kvantoriumnel/rzd_project/hoverboard-firmware-hack-FOC-main/docs/pictures/mainboard_pinout.png

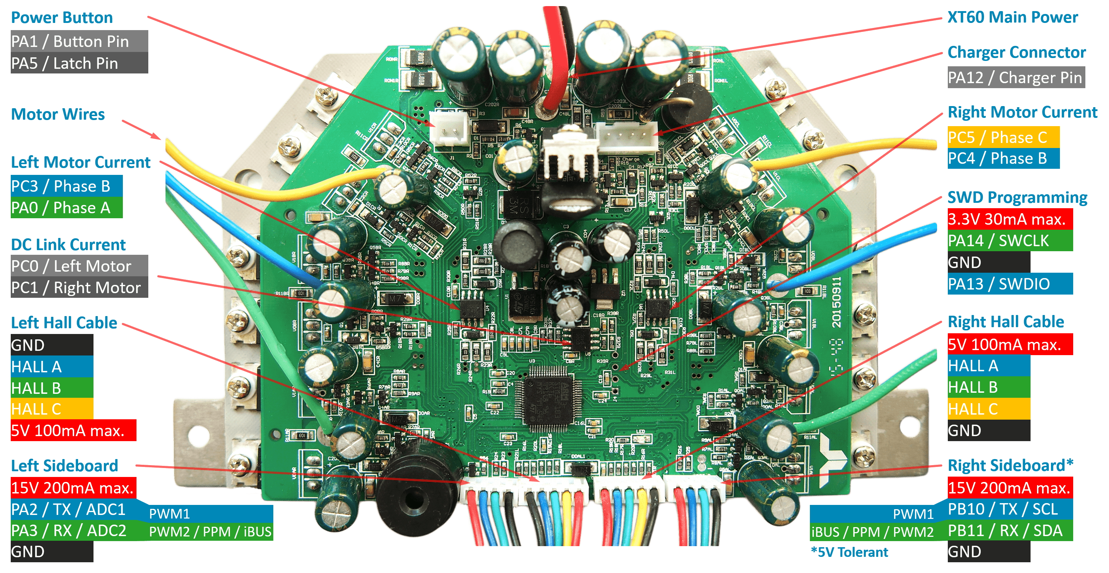
hoverboard-firmware-hack-FOC-main/docs/pictures/mainboard_pinout.png
