kvantoriumnel/rzd_project/README.md

# АРГУС-01

> **Переносной роботизированный комплекс для автономного мониторинга и диагностики на объектах железнодорожной инфраструктуры**

---

## О проекте

**«Аргус-01»** — это переносной роботизированный комплекс, разработанный командой **детского технопарка «Кванториум» НЭЛ (г. Пенза)**. 

Комплекс представляет собой две рельсовые тележки на мотор-колёсах со съёмными поперечинами. Над каждым рельсом установлен свой комплект датчиков, а сама колея задаёт маршрут движения. 

Проект **не заменяет** тяжелые вагоны-путеизмерители и дефектоскопы, а **закрывает промежутки между их проходами**, которые в настоящее время закрываются пешим обходом бригад.

*   **Проблема:** Между проходами диагностических средств путь осматривает пешком бригада из 2 человек (до 10 км за смену) на действующем пути.
*   **Решение:** Автономная тележка, которая проходит этот маршрут быстрее, безопаснее и собирает больше данных.

---

##  Ключевые особенности и функции

*   **Автономность:** План — 90% операций без оператора (сейчас — не менее 70%). Управление можно перехватить с пульта.
*   **Обнаружение дефектов:** По запросу заказчика — до **18 классов** по № 2499р и № 2288р (код и степень опасности). На конкурсе заявлено 3 класса.
*   **Универсальность колеи:** Подходит для магистральных путей (1520 мм), европейской колеи (1435 мм), узкоколейных и детских железных дорог (750 мм), промышленных и карьерных (600–1067 мм). Колея задаётся длиной поперечины и параметром ПО. Пороги — под тип рельса (P24–P75).
*   **Мобильность:** Масса ≈ 40 кг. Установка занимает 15 минут. Комплекс разборный и перевозится в защитном корпусе.
*   **Нештатные ситуации:** 
    *   Препятствие — стоп за 0,5 м.
    *   Потеря связи — стоп через 0,5 с.
    *   Удар на стыке фиксирует IMU.

---

##  Технические характеристики

| Параметр | Значение |
| :--- | :--- |
| **Тип** | Рельсовый, 2 тележки, мотор-колёса Ø254 мм |
| **Скорость** | 0,3–0,5 м/с |
| **Колея** | 750 / 1520 мм (смена поперечин) |
| **Датчики** | 2 камеры, 4 лазерных дальномера, 2 IMU, 2 ультразвуковых датчика |
| **Вычислительное** | Ноутбук с GPU, ESP32; Wi-Fi, пульт управления |
| **Работа / Ход** | Прототип: до 15 мин / до 0,45 км. **Серийный: до 5 ч / до 9 км** |
| **Связь** | С пульта — до 3 км (прямая видимость) |
| **Измерение** | Ступенька и зазор — лазерным дальномером; колея — двумя дальномерами на рабочие грани |

---

## Путь оператора

1.  **Монтаж (15 мин):** Перемещение оборудования в защитном корпусе по маршруту и установка на пути.
2.  **Инициализация:** Формирование задания на устройстве оператора (дистанция, выбор датчиков).
3.  **Проверка:** Калибровка колеи по шаблону, статус «норма».
4.  **Диагностика:** Комплекс работает автономно. На экране отображаются дефекты. Пульт имеет функции аварийной остановки и дистанционного перехвата.
5.  **Отчёт:** Таблица дефектов, снимки с рамками и классами, журнал CSV и сводка по проходу — сразу после прохода.
6.  **Демонтаж:** Снятие комплекса и укладка в защитный корпус.

---

## Экономическая и социальная целесообразность

### Сравнение с аналогами

| Аналог | Плюсы | Минусы |
| :--- | :--- | :--- |
| **Вагон-лаборатория «Интеграл»** | ≈ 200 параметров, до 140 км/ч | Дорого, проходы по графику, редко |
| **Тележка ПТ-7МК** | Колея ± 1 мм | ≈ 2,3 млн ₽, ведёт человек |
| **RailPod (США)** | Автономна, камеры и лидар | Колея 1435, в РФ недоступна |

### Финансовые показатели

*   **Стоимость прототипа:** 336 614 ₽ (материалы, специалисты, оборудование, интеграция).
*   **Серийный комплект:** 1,02 млн ₽ (при партии 100 шт.), что составляет **44% цены ПТ-7МК**.
*   **Стоимость 1 км осмотра:** **537 ₽** (против 862 ₽ пешком, экономия ~38%).
*   **Социальный эффект:** Экономия **7 680 чел.-ч в год** (снижение работы людей на действующем пути).
*   **Выигрыш покупателя (дистанция пути):** 
    *   Общий парк на 2 соседние дистанции по 100 км.
    *   4 осмотра в месяц, парку передано 50% пеших осмотров.
    *   Необходимо: 3 комплекса + 1 оператор.
    *   Вложения: 4,07 млн ₽.
    *   **Экономия: 2,38 млн ₽ в год.**
    *   **Окупаемость: 21 месяц.**
    *   NPV за 5 лет: 4,09 млн ₽ (ставка 14%).
    *   *При 30% осмотров окупаемость — 38 мес, при 70% — 20 мес.*

---

##  Команда проекта

*   **Кардашов Дмитрий Сергеевич** — схемотехник-электронщик
*   **Андриянов Владислав Евгеньевич** — программист (компьютерное зрение)
*   **Штыров Артур Сергеевич** — инженер-конструктор

**Организация:** Детский технопарк «Кванториум» НЭЛ, г. Пенза.
