kvantoriumnel/rzd_project/hoverboard-firmware-hack-FOC-main/docs/pictures/mainboard_pics.pptx

PA1 / Button Pin

PA5 / Latch Pin

Power Button

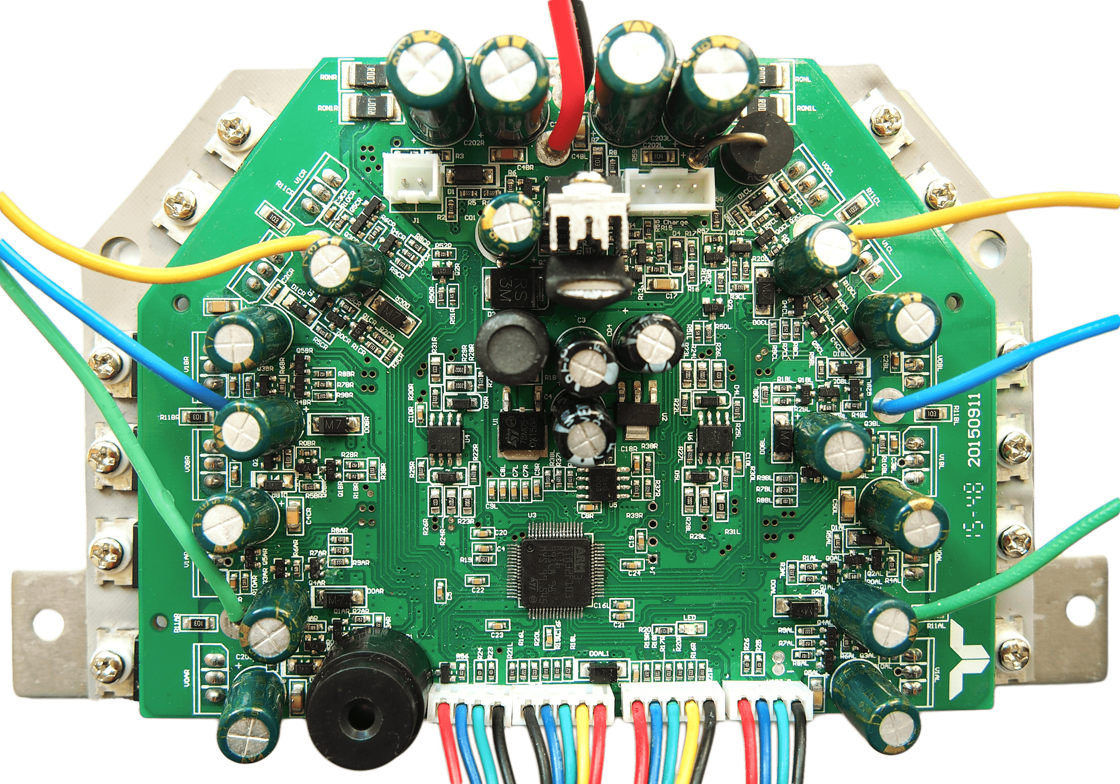
[picture p3: figure]

XT60 Main Power

Charger Connector

PA12 / Charger Pin

Motor Wires

PC5 / Phase C

Right Motor Current

PC4 / Phase B

PC3 / Phase B

Left Motor Current

PA0 / Phase A

SWD Programming

3.3V 30mA max.

DC Link Current

PC0 / Left Motor

PC1 / Right Motor

PA13 / SWDIO

GND

PA14 / SWCLK

Left Hall Cable

GND

HALL A

Right Hall Cable

5V 100mA max.

HALL A

5V 100mA max.

HALL C

HALL B

HALL C

GND

HALL B

Left Sideboard

15V 200mA max.

PA2 / TX / ADC1

PA3 / RX / ADC2

PWM1

PWM2 / PPM / iBUS

PWM1

iBUS / PPM / PWM2

Right Sideboard*

15V 200mA max.

PB10 / TX / SCL

PB11 / RX / SDA

GND

*5V Tolerant

GND

## Slide 2

VARIANT_HOVERCAR

Power Button

RC circuit (optional)

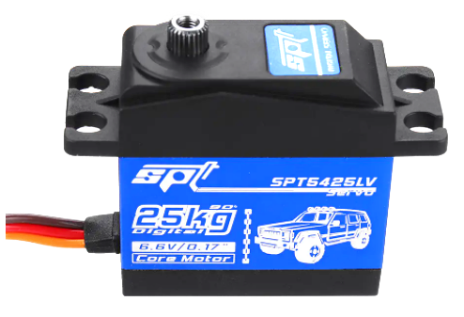
[picture p4: figure]

Steering Servo
min. 25kg

XT60 Main Power

VDD 36V - 42V

FOC
Sinusoidal
Commutation

Pedals
RC

Voltage
Speed
Torque

Pull-down
resistors

Left Cable

GND

Switch

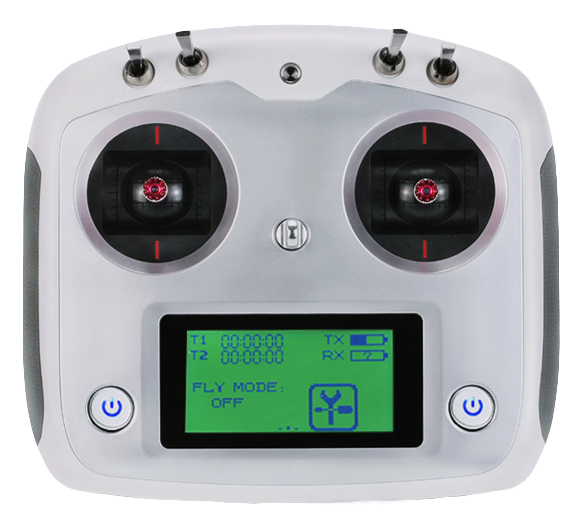
[picture p5: figure]

Input

Control Type

Flysky i6S

Control Mode

Field W.

Off
On

PA2 / TX / ADC1

100k

100k

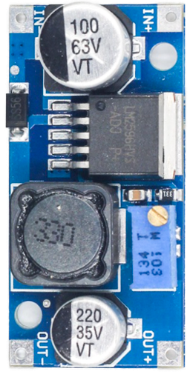
[picture p6: figure]

In: 36V - 42V

DC-DC Converter
LM2596HV

Out: 6.6V

CH4 / Servo

CH7

SWA

CH8

SWB

CH9

SWC

CH10

SWD

CH1 / Steer

CH2 / Speed

CH2 Failsafe: 0%

PA3 / RX / ADC2

GND

3.3V 30mA max.

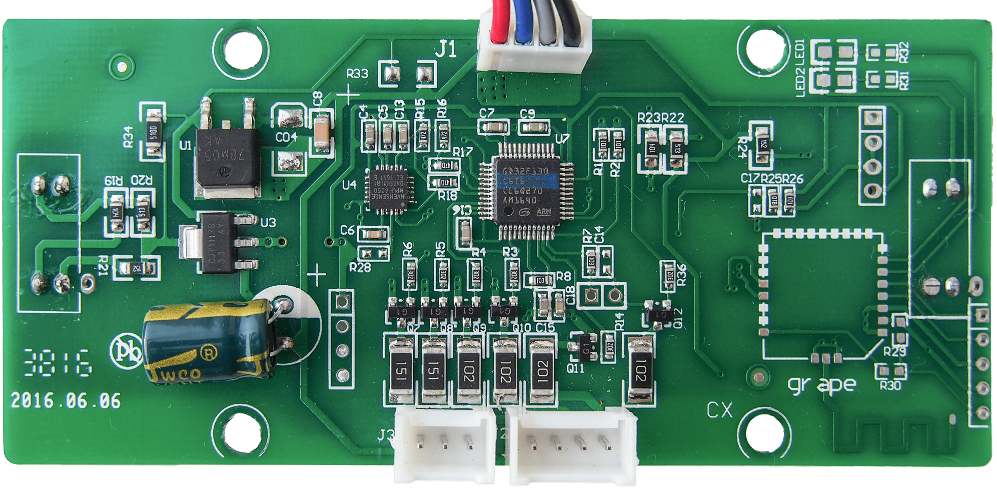
[picture p7: figure]
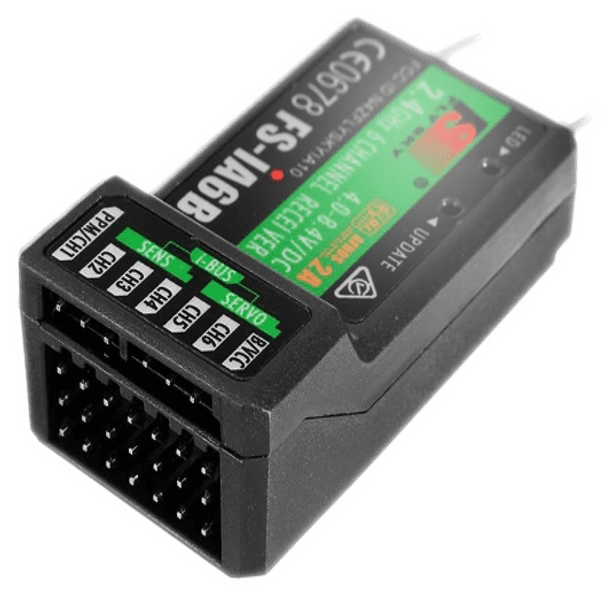
[picture p8: figure]

Right Cable

Brake

Throttle

CH4

parallel connection

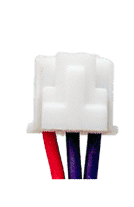
[picture p9: figure]
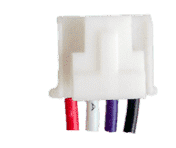
[picture p10: figure]

100 Ohm

FS-iA6B iBUS

GND

PA10 / AUX_RX

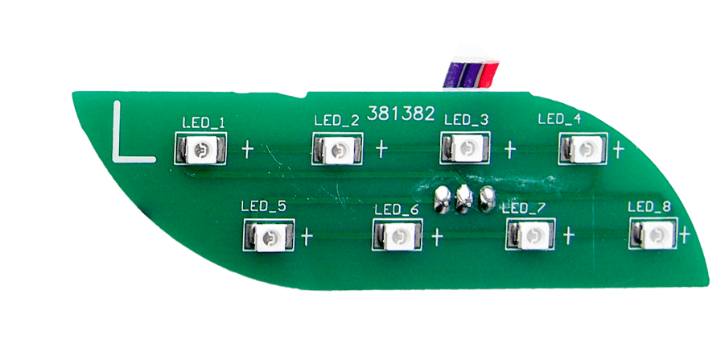
[picture p11: figure]
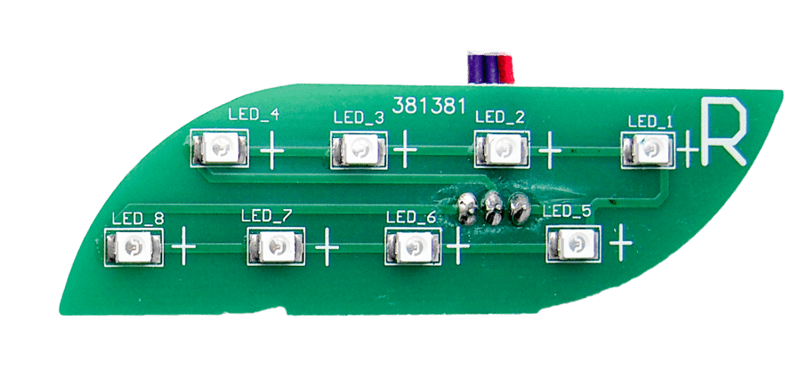
[picture p12: figure]

Front LEDs

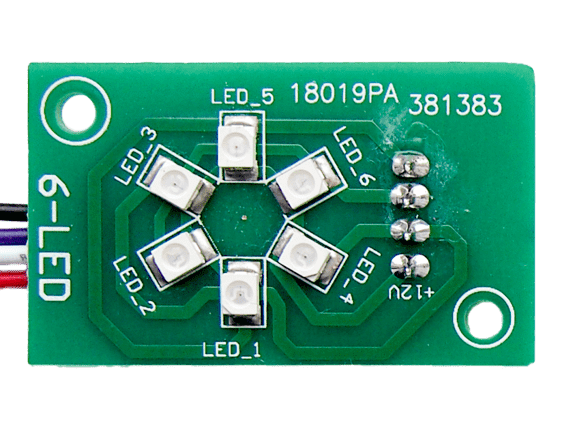
[picture p13: figure]

Battery Level
