kvantoriumnel/rzd_project/hoverboard-firmware-hack-FOC-main/docs/pictures/phase_currents_ADC.pptx

IDEAL AREA FOR CURRENT SAMPLING

M2

M2

M2

OBSERVED SPIKES at 90% Duty Cycle
M1 | M2
Yes (Light) | Yes (Hard)
Yes (Hard) | No
Yes (Light) | No
? todo | ? todo

Low FETs ON

Phase Currents
(assumed)

AdcClockSelection = RCC_ADCPCLK2_DIV8;
M1, M2 = 7.5; DC_Link = 13.5;

Default

M1

DC
Link

AdcClockSelection = RCC_ADCPCLK2_DIV8;
M1, M2 = 1.5; DC_Link = 13.5;

M1

DC
Link

AdcClockSelection = RCC_ADCPCLK2_DIV4;
DC_Link = 1.5; M1, M2 = 1.5;

AdcClockSelection = RCC_ADCPCLK2_DIV2;
DC_Link = 7.5; M1, M2 = 1.5;

DC
Link

DC
Link

M1

M1

M2

Still To Try

## Slide 2

TIM8

ADC_M1

Interrupt Mot 1

ADC_M2

Interrupt Mot 2

TIM1

DC
Link

M1

M2

## Slide 3

TIM8 - LEFT

ADC 1

DC Link
RIGHT

M_LEFT
Pha_A

M_RIGHT
Pha_B

Rest

FOC Mot 1 / FOC Mot 2

TIM1 - RIGHT

ADC 2

DC Link
LEFT

M_LEFT
Pha_B

M_RIGHT
Pha_C

Rest
