kvantoriumnel/rzd_project/hoverboard-firmware-hack-FOC-main/docs/pictures/FieldWeakening.png

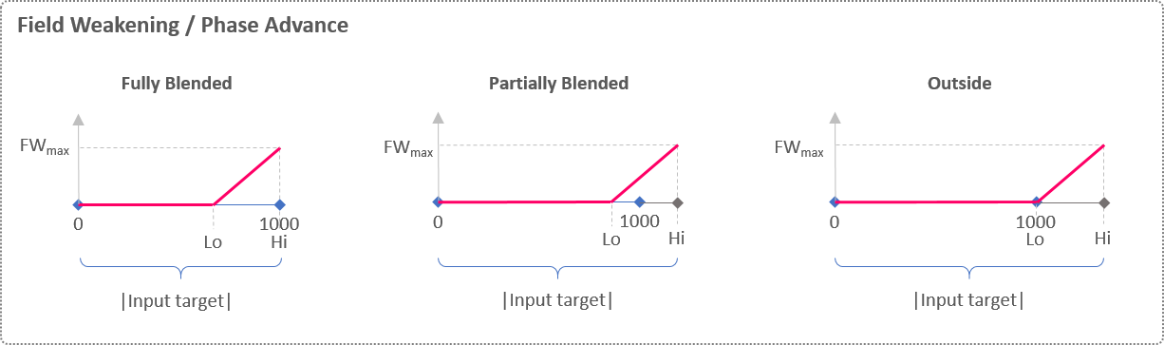
hoverboard-firmware-hack-FOC-main/docs/pictures/FieldWeakening.png
