kvantoriumnel/rzd_project/hoverboard-firmware-hack-FOC-main/docs/pictures/hoverboard_wheel.JPG

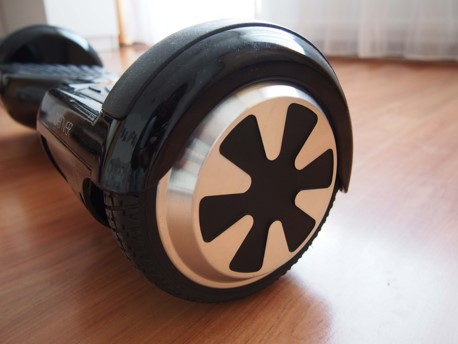
hoverboard-firmware-hack-FOC-main/docs/pictures/hoverboard_wheel.JPG
