kvantoriumnel/rzd_project/hoverboard-firmware-hack-FOC-main/docs/pictures/motor_ferite1.JPG

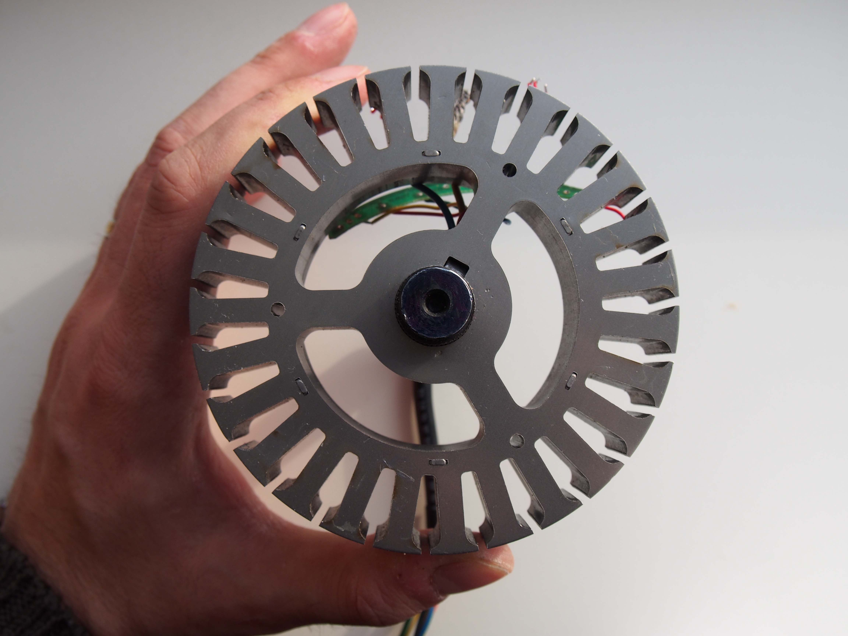
hoverboard-firmware-hack-FOC-main/docs/pictures/motor_ferite1.JPG
