kvantoriumnel/rzd_project/hoverboard-firmware-hack-FOC-main/docs/pictures/motor_ferite2.png

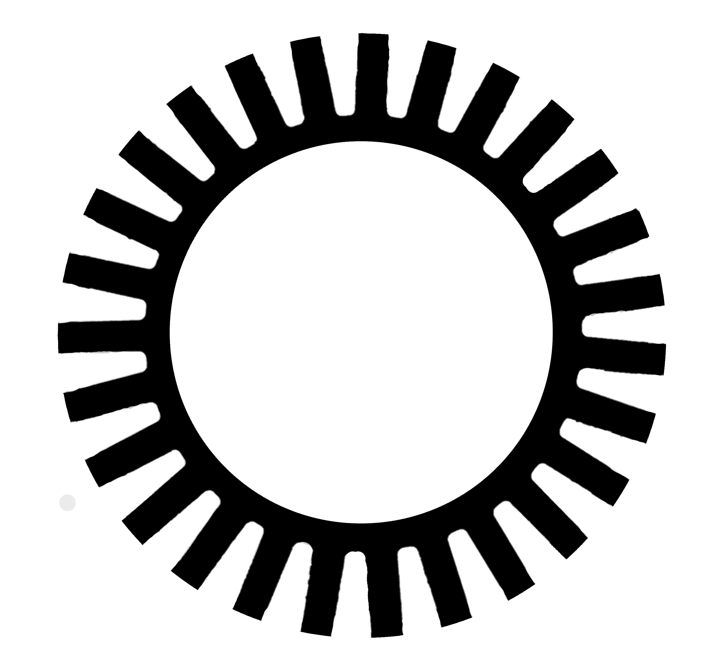
hoverboard-firmware-hack-FOC-main/docs/pictures/motor_ferite2.png
