kvantoriumnel/rzd_project/hoverboard-firmware-hack-FOC-main/docs/pictures/motor_inside.jpg

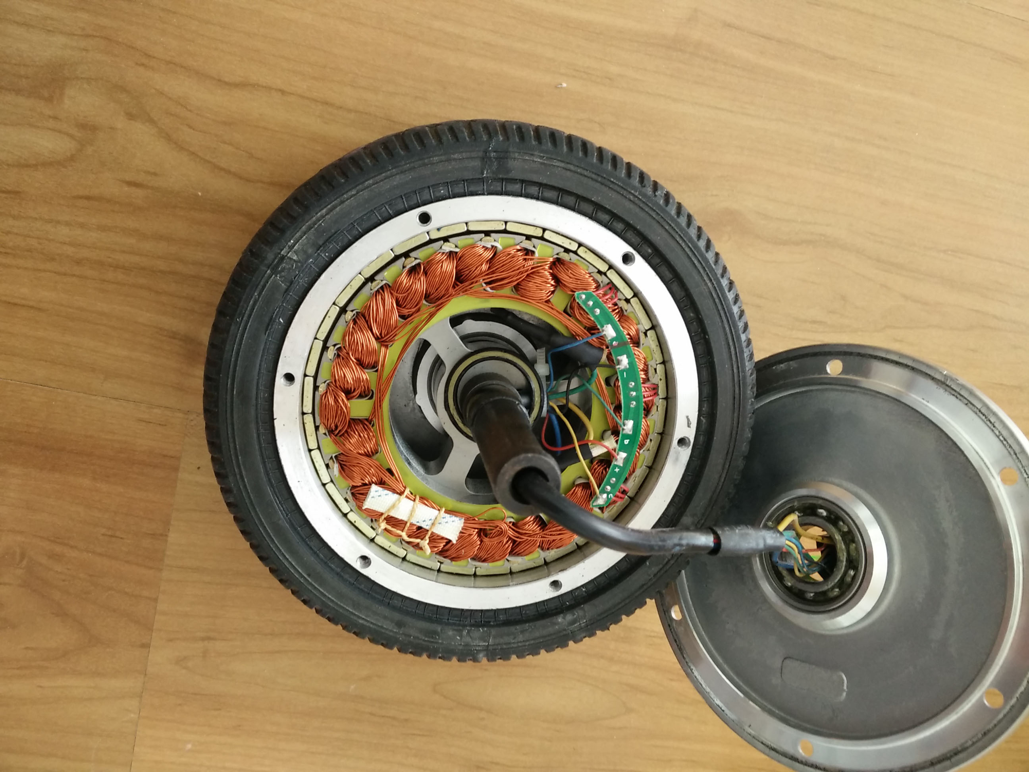
hoverboard-firmware-hack-FOC-main/docs/pictures/motor_inside.jpg
