kvantoriumnel/rzd_project/hoverboard-firmware-hack-FOC-main/docs/pictures/motor_VESC_params.png

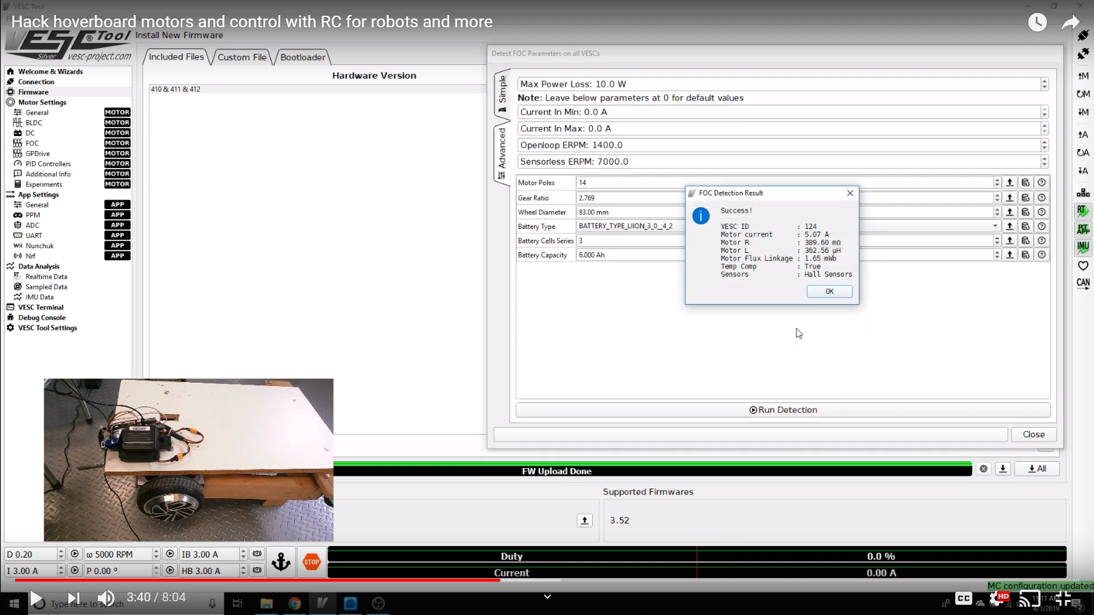
hoverboard-firmware-hack-FOC-main/docs/pictures/motor_VESC_params.png
