kvantoriumnel/rzd_project/hoverboard-firmware-hack-FOC-main/docs/pictures/motor_winding.png

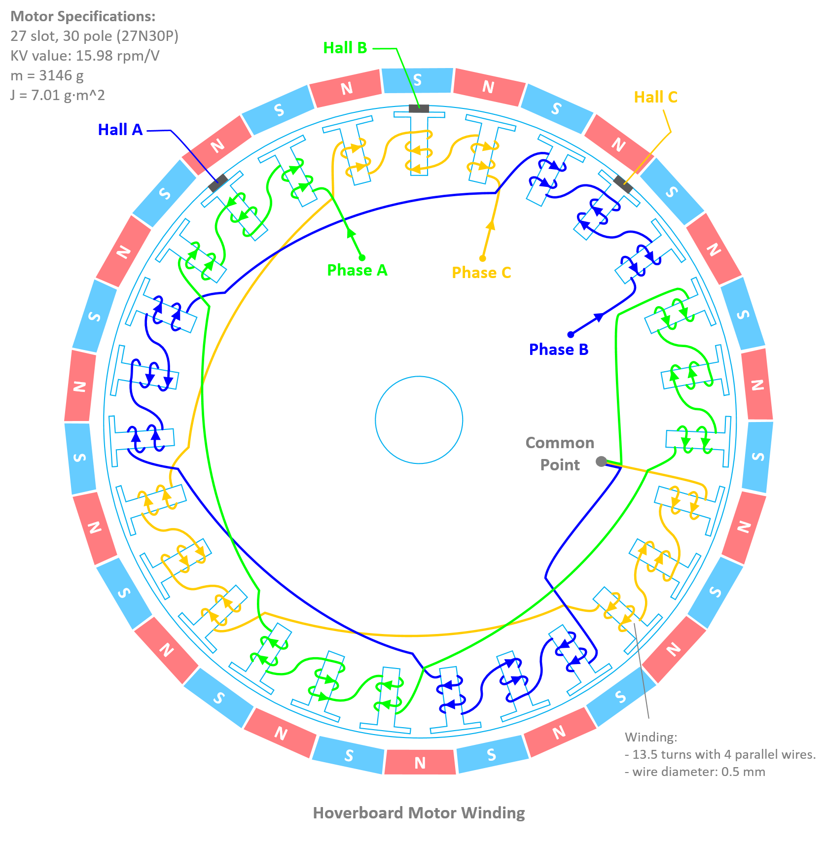
hoverboard-firmware-hack-FOC-main/docs/pictures/motor_winding.png
