kvantoriumnel/rzd_project/hoverboard-firmware-hack-FOC-main/docs/pictures/videos_preview/com_foc_const.png

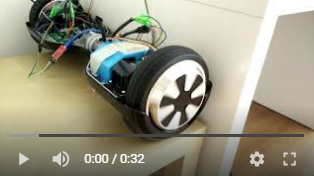
hoverboard-firmware-hack-FOC-main/docs/pictures/videos_preview/com_foc_const.png
