kvantoriumnel/rzd_project/hoverboard-firmware-hack-FOC-main/docs/pictures/videos_preview/com_foc_var.png

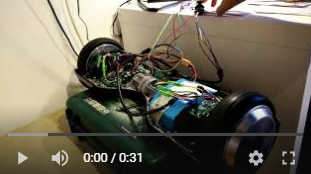
hoverboard-firmware-hack-FOC-main/docs/pictures/videos_preview/com_foc_var.png
