kvantoriumnel/rzd_project/hoverboard-firmware-hack-FOC-main/docs/pictures/videos_preview/cruise_control.png

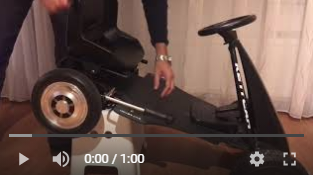
hoverboard-firmware-hack-FOC-main/docs/pictures/videos_preview/cruise_control.png
