kvantoriumnel/rzd_project/hoverboard-firmware-hack-FOC-main/docs/pictures/videos_preview/hovercar_intro.png

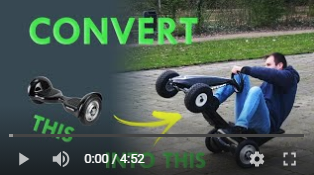
hoverboard-firmware-hack-FOC-main/docs/pictures/videos_preview/hovercar_intro.png
