kvantoriumnel/rzd_project/hoverboard-firmware-hack-FOC-main/docs/pictures/videos_preview/hovercar_pedals.png

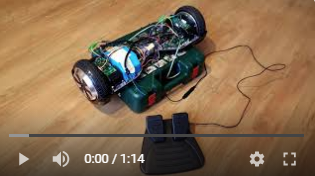
hoverboard-firmware-hack-FOC-main/docs/pictures/videos_preview/hovercar_pedals.png
