kvantoriumnel/rzd_project/hoverboard-firmware-hack-FOC-main/docs/pictures/videos_preview/serial_com.png

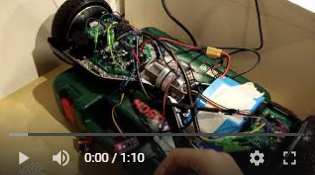
hoverboard-firmware-hack-FOC-main/docs/pictures/videos_preview/serial_com.png
