kvantoriumnel/rzd_project/hoverboard-firmware-hack-FOC-main/docs/pictures/wiki_hovercar/hovercar_rc.png

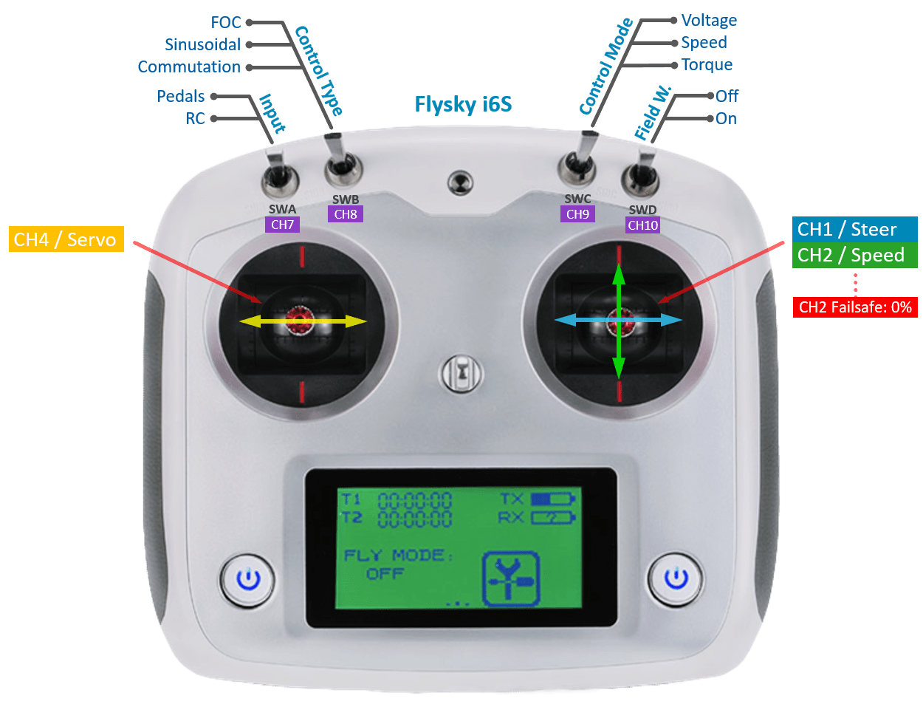
hoverboard-firmware-hack-FOC-main/docs/pictures/wiki_hovercar/hovercar_rc.png
