kvantoriumnel/rzd_project/hoverboard-firmware-hack-FOC-main/docs/pictures/wiki_unlock/unlock_mcu_3.png

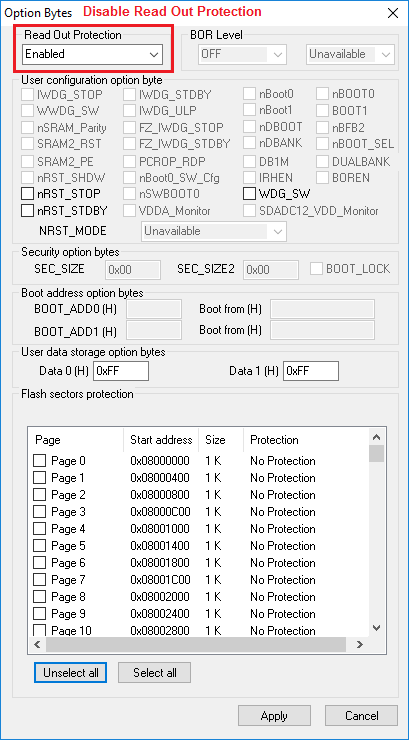
hoverboard-firmware-hack-FOC-main/docs/pictures/wiki_unlock/unlock_mcu_3.png
