kvantoriumnel/rzd_project/hoverboard-firmware-hack-FOC-main/docs/literature/ODrive motor guide.xlsx

Sheet: Motors
(feilds highlighted in blue are inputs) | kv | Max current | Max voltage | price | Weight | Link | Torque | No-load speed |  |  | Force | Acceleration | Time to base speed | distance to base speed | Power at base speed | Base speed kinetic energy | Encoder freq. (base speed)
 | rpm/v | A | V | USD | g |  | Nm | rpm | rad/s | m/s | N | m/s^2 | ms | mm | W | J | kHz
Tarot 4008 330kv | 330 | 25 | 24 | 32 | 80 | https://www.aliexpress.com/item/F17601-Tarot-4008-Martin-RC-Brushess-Motor-TL2955-RC-Quadcopter-Motor-for-Quadcopter-Multicopter-Drone/32697306634.html | 0.63 | 7920 | 829.38 | 7.92 | 65.61 | 21.89 | 361.74 | 1432.50 | 519.6152423 | 59.59 | 270.336
Turnigy Aerodrive SK3 - 4250-350kv | 350 | 50 | 20 | 36 | 266 | https://hobbyking.com/en_us/turnigy-aerodrive-sk3-4250-350kv-brushless-outrunner-motor.html | 1.18 | 7000 | 733.04 | 7.00 | 123.72 | 41.29 | 169.55 | 593.42 | 866.0254038 | 46.55 | 238.9333333
ACK 5312CP - 330KV | 330 | 50 | 30 | 41 | 230 | https://hobbyking.com/en_us/ack-5312cp-330kv-high-performance-brushless-multicopter-motor-6-8s-cw.html | 1.25 | 9900 | 1036.73 | 9.90 | 131.22 | 43.79 | 226.09 | 1119.14 | 1299.038106 | 93.11 | 337.92
Turnigy Aerodrive SK3 - 5065-275kv | 275 | 60 | 40 | 56 | 530 | https://hobbyking.com/en_us/turnigy-aerodrive-sk3-5065-275kv-brushless-outrunner-motor.html | 1.80 | 10560 | 1105.84 | 10.56 | 188.95 | 63.05 | 167.47 | 884.26 | 1995.32253 | 105.94 | 360.448
ODrive Robotics D5065 - 270kv | 270 | 65 | 32 | 69 | 420 | https://odriverobotics.com/shop/odrive-custom-motor-d5065 | 1.99 | 8640 | 904.78 | 8.64 | 208.49 | 69.57 | 124.18 | 536.47 | 1801.33284 | 70.92 | 294.912
KEDA 63-64 190KV | 190 | 50 | 40 | 49 | 670 | https://hobbyking.com/en_us/kd-53-30-high-voltage-brushless-outrunner-190kv.html | 2.18 | 7296 | 764.04 | 7.30 | 227.90 | 76.05 | 95.93 | 349.97 | 1662.768775 | 50.57 | 249.0368
ODrive Robotics D6374 - 150kv | 150 | 70 | 48 | 99 | 890 | https://odriverobotics.com/shop/odrive-custom-motor-d6374-150kv | 3.86 | 5760 | 603.19 | 5.76 | 404.15 | 134.87 | 42.71 | 123.00 | 2327.876285 | 31.52 | 196.608
Turnigy Aerodrive SK3 - 6374-149kv | 149 | 68 | 48 | 80 | 840 | https://hobbyking.com/en_us/turnigy-aerodrive-sk3-6374-149kv-brushless-outrunner-motor.html | 3.77 | 5721.6 | 599.16 | 5.72 | 395.23 | 131.89 | 43.38 | 124.10 | 2261.365534 | 31.10 | 195.29728
9235-100KV Turnigy Multistar | 100 | 57 | 48 | 103 | 674 | https://hobbyking.com/en_us/9235-100kv-turnigy-multistar-brushless-multi-rotor-motor.html | 4.71 | 3840 | 402.12 | 3.84 | 493.63 | 164.73 | 23.31 | 44.76 | 1895.556404 | 14.01 | 131.072
Hoverboard Hub-motor | 16 | 25 | 48 | 40 | a lot | https://www.ebay.com/sch/i.html?_nkw=hoverboard+replacement+wheel | 12.92 | 614.4 | 64.34 | 0.61 | 1353.16 | 451.56 | 1.36 | 0.42 | 831.3843876 | 0.36 | 20.97152
 |  | Note that torque and current ratings are with Extremely good forced air cooling
 |  | See Torque derating curve
Parameter | Value
Bus voltage | 48 | V
Max modulation | 0.8
Load mass | 1.9 | kg
Rotor inertia | 0.0001 | kg m^2
Pulley circumference or screw pitch | 60 | mm/rev
Radius | 0.009549296586 | m/rad
Reflected inertia | 1.10 | kg
Peak brake power | 1200 | W
Brake resistor resistance | 1.92 | ohm
Conversion constants
I by kv to Nm | 8.269933431
Encoder
Encoder resolution | 2048 | ppr
Linear resolution | 7.32 | um
Max speed | 15000 | RPM
There are more tabs!

Sheet: Torque derating
Speed | Forced air | Good airflow | No airflow
0.025 | 1 | 0.5 | 0.3
0.05 | 1 | 0.5 | 0.3
0.075 | 1 | 0.5 | 0.3
0.1 | 1 | 0.5 | 0.3
0.125 | 1 | 0.5 | 0.3
0.15 | 1 | 0.5 | 0.3
0.175 | 1 | 0.5 | 0.3
0.2 | 1 | 0.5 | 0.3
0.225 | 1 | 0.5 | 0.3
0.25 | 1 | 0.5 | 0.3
0.275 | 1 | 0.5 | 0.3
0.3 | 1 | 0.5 | 0.3
0.325 | 1 | 0.5 | 0.3
0.35 | 1 | 0.5 | 0.3
0.375 | 1 | 0.5 | 0.3
0.4 | 1 | 0.5 | 0.3
0.425 | 1 | 0.5 | 0.3
0.45 | 1 | 0.5 | 0.3
0.475 | 1 | 0.5 | 0.3
0.5 | 1 | 0.5 | 0.3
0.525 | 1 | 0.5 | 0.3
0.55 | 1 | 0.5 | 0.3
0.575 | 1 | 0.5 | 0.3
0.6 | 1 | 0.5 | 0.3
0.625 | 1 | 0.5 | 0.3
0.65 | 1 | 0.5 | 0.3
0.675 | 1 | 0.5 | 0.3
0.7 | 1 | 0.5 | 0.3
0.725 | 0.75 | 0.5 | 0.3
0.75 | 0.5 | 0.5 | 0.3
0.775 | 0.25 | 0.25 | 0.25
0.8 | 0 | 0 | 0
0.825
0.85
0.875
0.9
0.925
0.95
0.975
1

Sheet: MoI
 | Rotor mass | Rotor diameter | Shaft length | Shaft diameter | Shaft density | Shaft mass | Shaft MoI | End Face thickness | End face density | End face mass | End Face MoI | Rotor casing mass | Rotor casing MoI | Total MoI
 | g | mm | mm | mm | kg/m^3 | g | kg*m^2 | mm | kg/m^3 | g | kg*m^2 | g | kg*m^2 | kg*m^2
Red 5065 | 190 | 50 | 83 | 8 | 7850 | 32.7504751 | 5.240076015e-07 | 7.5 | 1350 | 19.88039101 | 6.212622191e-06 | 137.3691339 | 8.585570868e-05 | 9.259233848e-05

Sheet: Trajectories
 | price | Base speed | Force | Acceleration | Time to base speed | distance to base speed |  | Travel time as a function of tavel distance, trapezoidal motion profile |  |  |  |  |  |  |  | ms
Motor | USD | m/s | N | m/s^2 | ms | mm |  | 50 | 77 | 118 | 181 | 277 | 425 | 652 | 1000 | mm
Turnigy Aerodrive SK3 - 4250-350kv | 36 | 7.00 | 123.72 | 41.29 | 169.55 | 593.42 | Turnigy Aerodrive SK3 - 4250-350kv | 69.60 | 86.37 | 106.92 | 132.42 | 163.82 | 202.92 | 251.34 | 311.26
ACK 5312CP - 330KV | 41 | 9.90 | 131.22 | 43.79 | 226.09 | 1119.14 | ACK 5312CP - 330KV | 67.58 | 83.87 | 103.82 | 128.59 | 159.07 | 197.04 | 244.05 | 302.24
ODrive Robotics D5065 - 270kv | 69 | 8.64 | 208.49 | 69.57 | 124.18 | 536.47 | ODrive Robotics D5065 - 270kv | 53.62 | 66.54 | 82.37 | 102.01 | 126.20 | 156.31 | 193.61 | 239.78
KEDA 63-64 190KV | 49 | 7.30 | 227.90 | 76.05 | 95.93 | 349.97 | KEDA 63-64 190KV | 51.28 | 63.64 | 78.78 | 97.57 | 120.70 | 149.51 | 185.18 | 232.99
ODrive Robotics D6374 - 150kv | 99 | 5.76 | 404.15 | 134.87 | 42.71 | 123.00 | ODrive Robotics D6374 - 150kv | 38.51 | 47.79 | 59.16 | 73.27 | 90.80 | 116.49 | 155.90 | 216.32
9235-100KV Turnigy Multistar | 103 | 3.84 | 493.63 | 164.73 | 23.31 | 44.76 | 9235-100KV Turnigy Multistar | 34.84 | 43.24 | 54.04 | 70.45 | 95.45 | 133.99 | 193.10 | 283.73
Hoverboard Hub-motor | 40 | 0.61 | 1353.16 | 451.56 | 1.36 | 0.42 | Hoverboard Hub-motor | 82.74 | 126.69 | 193.42 | 295.96 | 452.21 | 693.09 | 1062.56 | 1628.96
Parameter | Value
full travel distance | 1000 | mm
minimum travel distance | 50 | mm

Sheet: Efficiency
#REF! | kv | Max current | Resistance | no load |  | loss ratio | Optimal ratio | Optimal gearing | efficiency | Optimal speed at rated current |  |  | I at V
(feilds highlighted in blue are inputs) | rpm/v | A | mOhm | A | V | A/V | A/V | Ncm/krpm |  | V | rpm | W | 24 | 36 | 48 | V
#REF! | #REF! | #REF! |  |  |  | #DIV/0! | #DIV/0! | #DIV/0! | #DIV/0! | #REF! | #REF! | #REF! | #DIV/0! | #DIV/0! | #DIV/0!
#REF! | #REF! | #REF! |  |  |  | #DIV/0! | #DIV/0! | #DIV/0! | #DIV/0! | #REF! | #REF! | #REF! | #DIV/0! | #DIV/0! | #DIV/0!
#REF! | #REF! | #REF! |  |  |  | #DIV/0! | #DIV/0! | #DIV/0! | #DIV/0! | #REF! | #REF! | #REF! | #DIV/0! | #DIV/0! | #DIV/0!
#REF! | #REF! | #REF! |  |  |  | #DIV/0! | #DIV/0! | #DIV/0! | #DIV/0! | #REF! | #REF! | #REF! | #DIV/0! | #DIV/0! | #DIV/0!
Turnigy Aerodrive SK3 - 4250-350kv | 350 | 50 |  |  |  | #DIV/0! | #DIV/0! | #DIV/0! | #DIV/0! | #DIV/0! | #DIV/0! | #DIV/0! | #DIV/0! | #DIV/0! | #DIV/0!
Turnigy Aerodrive SK3 - 5065-275kv | 275 | 60 |  |  |  | #DIV/0! | #DIV/0! | #DIV/0! | #DIV/0! | #DIV/0! | #DIV/0! | #DIV/0! | #DIV/0! | #DIV/0! | #DIV/0!
#REF! | #REF! | #REF! |  |  |  | #DIV/0! | #DIV/0! | #DIV/0! | #DIV/0! | #REF! | #REF! | #REF! | #DIV/0! | #DIV/0! | #DIV/0!
ODrive Robotics D5065 - 270kv | 270 | 65 |  |  |  | #DIV/0! | #DIV/0! | #DIV/0! | #DIV/0! | #DIV/0! | #DIV/0! | #DIV/0! | #DIV/0! | #DIV/0! | #DIV/0!
#REF! | #REF! | #REF! |  |  |  | #DIV/0! | #DIV/0! | #DIV/0! | #DIV/0! | #REF! | #REF! | #REF! | #DIV/0! | #DIV/0! | #DIV/0!
ODrive Robotics D6374 - 150kv | 150 | 70 |  |  |  | #DIV/0! | #DIV/0! | #DIV/0! | #DIV/0! | #DIV/0! | #DIV/0! | #DIV/0! | #DIV/0! | #DIV/0! | #DIV/0!
Turnigy Aerodrive SK3 - 6374-149kv | 149 | 68 |  |  |  | #DIV/0! | #DIV/0! | #DIV/0! | #DIV/0! | #DIV/0! | #DIV/0! | #DIV/0! | #DIV/0! | #DIV/0! | #DIV/0!
KEDA 63-64 190KV | 190 | 50 |  |  |  | #DIV/0! | #DIV/0! | #DIV/0! | #DIV/0! | #DIV/0! | #DIV/0! | #DIV/0! | #DIV/0! | #DIV/0! | #DIV/0!
9235-100KV Turnigy Multistar | 100 | 57 |  |  |  | #DIV/0! | #DIV/0! | #DIV/0! | #DIV/0! | #DIV/0! | #DIV/0! | #DIV/0! | #DIV/0! | #DIV/0! | #DIV/0!
Hoverboard Hub-motor | 16 | 25 |  |  |  | #DIV/0! | #DIV/0! | #DIV/0! | #DIV/0! | #DIV/0! | #DIV/0! | #DIV/0! | #DIV/0! | #DIV/0! | #DIV/0!
