kvantoriumnel/rzd_project/hoverboard-firmware-hack-FOC-main/docs/pictures/wiki_unlock/download_build.png

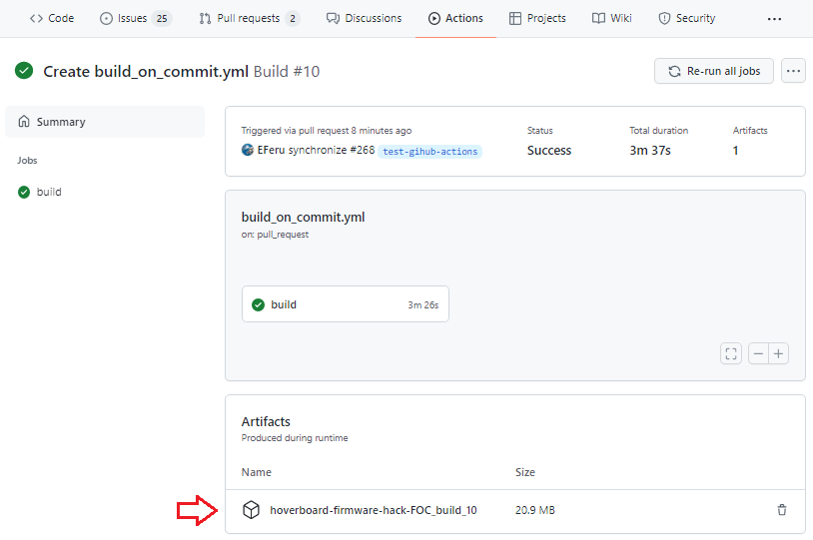
hoverboard-firmware-hack-FOC-main/docs/pictures/wiki_unlock/download_build.png
